IllyaMoskvin/nixie-counter/designs/back.png

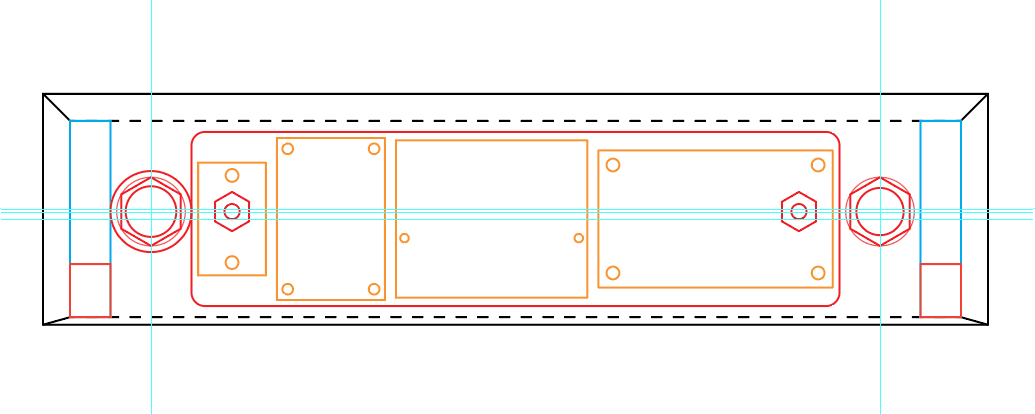
designs/back.png
