IllyaMoskvin/nixie-counter/designs/front.png

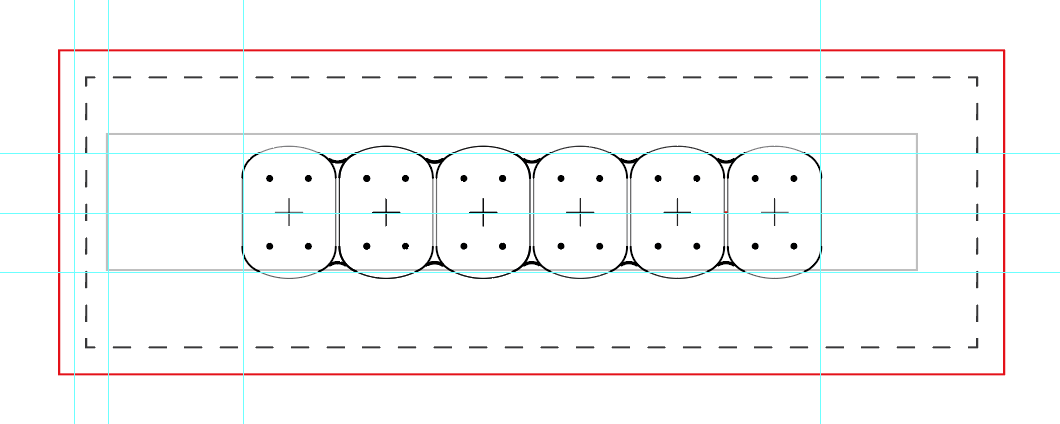
designs/front.png
