IllyaMoskvin/nixie-counter/designs/side.png

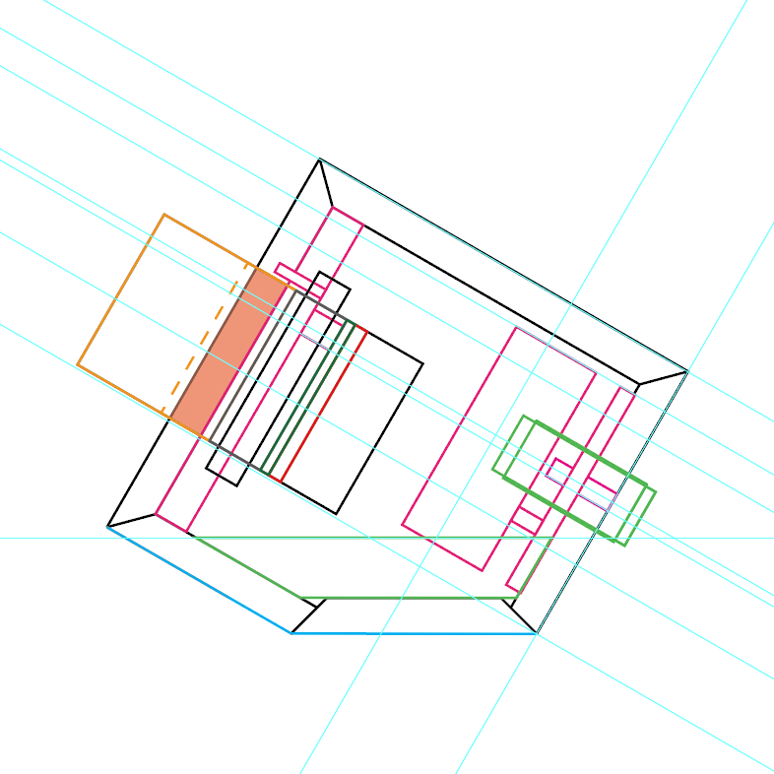
designs/side.png
