IllyaMoskvin/nixie-counter/images/config-webserver.png

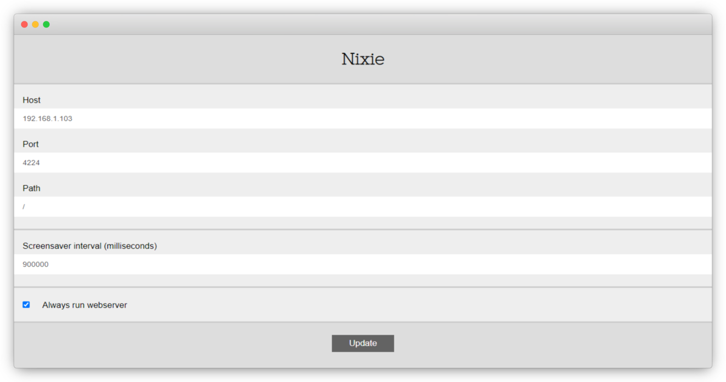
images/config-webserver.png
