IllyaMoskvin/nixie-counter/(commit log)

2019-08-25 Fix JSON parsing from HTTP response
    https://arduinojson.org/v6/example/http-client/
2019-09-10 Add NixieShowIP sketch
    This sketch is used to experiment with showing the ESP8266's local IP
    using a nixie marquee. At this stage, we can get the IP and display it
    via nixies, but it's truncated. We need to make it scroll.
2019-09-10 Add NixieAnimation sketch
    This sketch was used to develop a pleasing animation for changing nixie
    tube numbers under normal operation. The end result is an animation that
    changes nixies one at a time from left to right, i.e. most significant
    to least significant. The digits in each nixie tube are stacked, not in
    numerical order, but in one that's meant to prevent visual obstruction.
    For each tube, we identify where in the stack the current digit resides,
    and where in the stack the target digit resides. We then "move towards"
    the target digit by lighting up the digit in the stack that's one step
    closer to the target digit relative to the current digit. This creates
    an effect wherein numbers a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
    [NixieAnimation.ino]
2019-09-10 Prevent IP marquee from scrolling immediately
    [NixieShowIP.ino]
2019-09-10 Switch to ESP8266WebServer with snprintf to show form
    https://github.com/esp8266/Arduino/tree/master/libraries/ESP8266WebServer
2019-09-10 Send `Connection: close` headers
    https://github.com/esp8266/Arduino/issues/2457
    [NixieMain.ino, NixieServer.ino]
2019-09-10 Revert "Send `Connection: close` headers"
    This reverts commit 2e8b65c60012c0377a0dc5c6bf76fdea3fac4ca2.
    Caused duplicate "Connection: close" headers to be sent.
    [NixieMain.ino, NixieServer.ino]
2019-09-10 Call `client.stop()` before throwing errors
    This might be done automatically already, but can't hurt.
    [NixieMain.ino]
2019-09-10 Use F() macro for string literals
    Keeps strings in PROGMEM, streaming to SRAM.
    https://www.baldengineer.com/arduino-f-macro.html
    https://arduino.stackexchange.com/questions/19330/store-string-using-f-macro
    Sketch uses: 455120
    Globals use: 34388
    Local left: 47532
    Sketch free: 3710976
    Heap free: 42704 to 42816
    Heap frag: 26
2019-09-10 Reduce int variables to smaller data types
    Byte is Arduino-specific. Consider using "unsigned char" instead.
    https://forum.arduino.cc/index.php?topic=206959.0
    Sketch uses: 455140
    Globals use: 34336
    Local left: 47584
    Heap free: 42800 to 42912
    Heap frag: 4 (28)
    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
2019-09-10 Add OneButton library and stub state change
    Looks like I might need to switch to an async WiFi client and server.
    The button becomes non-responsive when the API request is being made.
    It doesn't feel right.
    [NixieMain.ino]
2019-09-10 Scroll local IP in webserver state
    For some reason, the rightmost dot lights up when the button is being
    held down. Need to debug where that interference is coming from. Also,
    need to add an interrupt to the button. AsyncClient is too low-level to
    be a viable option at this time.
    [NixieMain.ino]
2019-09-10 Separate `btnPin` from `button` vars
2019-09-10 Hotfix DP5 lighting up when button is LOW
    Long story short, I've looked at the schematics of the Doayee board and
    at the datasheets for the HV5122, and using the board with the ESP8266
    seems to be doable without level shifting. I tried the TXB0108 shifter,
    but I had a ton of noise due to clock issues, so I'm connecting the 5v
    nixie board to the 3.3v ESP8266 directly. I'm not the first:
    https://old.reddit.com/r/arduino/comments/83s09b/ive_always_wanted_a_nixie_clock_and_finally_made/
    Everything seems very stable, except this one thing.
    When the button is held down, if there is a dot in the second-to-last
    segment (currentDots[3]), then the dot in the last segment lights up
    as well. We hide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
    [NixieMain.ino]
2019-09-10 Reset API request timer when exiting web server state
    [NixieMain.ino]
2019-09-10 Restrict dot display fix to webserver state
    [NixieMain.ino]
2019-09-10 Add digit cycle to prevent cathode poisoning
    http://www.tube-tester.com/sites/nixie/different/cathode%20poisoning/cathode-poisoning.htm
    [NixieMain.ino]
2019-09-10 Remove `cycleActiveDelay` tracking
    There's no need to predict how long to wait for all tubes to blank. Just
    check if the tubes reached their end-state digits.
2020-06-15 Replace JSON parsing with naive `parseInt` call
    I want more flexibility over what the counter displays. I don't like the
    fact that it is hardcoded to check for `pagination.total`.
    [NixieMain.ino]
2020-06-15 Switch from HTTPS to HTTP
2020-06-26 Proxy query to AIC's API through Python server
    Together with the previous three commits, this allows me to change
    the logic for what is being displayed without having to reflash the
    ESP8266. Also, there's no need for HTTPS support or ArduinoJson now.
2020-06-26 Fix change check of IP to prevent animation reset
    Without this fix, this would always return false, which caused the IP
    scroll animation to reset.
    [NixieMain.ino]
2020-06-28 Use `ThreadingHTTPServer` instead of `HTTPServer`
    Accessing the server from Chrome causes it to hang, because Chrome keeps
    the connection open, possibly through its "page prefetch" feature:
    https://stackoverflow.com/questions/43146298
    https://stackoverflow.com/questions/42519629
2021-10-16 Add "Nixie Tubes" section to README
2021-10-16 Add "Doayee's Nixie Driver" section to README
2021-10-16 Add "Acrylic-Mounted PCBs" section to README
2021-10-16 Add "HV PSU: YanZeyuan’s NCH6100HV" section to README
2021-10-16 Add stub "Assembly" section with photos
2021-10-16 Add "Acrylic Plate for PCBs" section to "Assembly"
2021-10-16 Add "Walnut Wood Enclosure" section
2021-10-16 Add "Wiring" section
2021-10-16 Add "miTEC MSW-12A01 Button" section
    Fix earlier reference to 3/4" Forstner hole
2021-10-16 Add Git submodules for libraries and board core
2021-10-16 Extract, minify, and replace HTML in NixieMain
    [NixieMain.ino]
2021-10-16 Add electrical schematic
2021-10-16 Split "Assembly" table into two rows
2021-10-16 Add photo of IN-12B tubes
2021-10-17 Reduce first-frame delay in GIFs
